Whauu/EspressiScale/README.md

# EspressiScale

EspressiScale is a minimalist and affordable espresso scale designed to provide accurate measurements along with a built-in timer – perfect for both home and small coffee shop use.

## Features

- **Accurate Weighing:** Provides precise measurements for your espresso brewing.
- **Built-in Timer:** Monitors brewing time to ensure optimal extraction.
- **Minimalist Design:** A simple and modern solution focusing on essential features.
- **BLE:** It now supports both Gaggimate and Clevercoffee (Beanconqueror support coming oct).
- **Calibration:** Now built in.

## Makerworld
This was also published on [makerworld](https://makerworld.com/en/models/1212476-espressiscale-small-minimalist-espresso-scale#profileId-1227630) for easy 3D printing.

## Bill of Materials V1 (BOM)

| Quantity | Component | Details/Notes |
|---|---|---|
| 1 | [Lilygo T-Touch bar](https://lilygo.cc/products/t-touch-bar?variant=42880705102005) | |
| 1 | Battery | Any 3.7v rechargeable lithium battery (<10x34x48) |
| 1 | [500g Load Cell](https://www.aliexpress.com/item/1005006390450639.html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) | |
| 1 | [HX711](https://www.aliexpress.com/item/1005006293368575.html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) | High precision (available on AliExpress) |
|1 | [USB type C port](https://a.aliexpress.com/_EyspPbK) | Not yet implimented
| 4 | [M3x3.0 Threaded Inserts](https://cnckitchen.store/products/heat-set-insert-m3-x-3-short-version-100-pieces) | (I used CNCkitchen) |
| 2 | M3x10 Screws | M3x6 for V2 |
| 2 | M3x12 Screws | M3x8 for V2 |
| 2 | M3x12 Countersunk Screws | |
| - | Heat Shrink | |

### Optional Components

| Quantity | Component | Details/Notes |
|---|---|---|
| 2 | Extra Heated Inserts | |
| 2 | M3x6 Screws | M3x4 for V2 |

## Installation

1. Open [this](https://doc.espressiscale.com) website in chrome
2. Connect your scale and hold down boot while pressing res once, then releasing boot
3. Press Install button, selecting your scale (jtag), hit "install EspressiScale"
4. Once done, look for wifi AP "EspressiScale" and connect to it (Password: Espressi)
5. Put in the credentials for your home wifi.
6. Connect to the same wifi with any device and go to espressiscale.local
7. Press calibration and follow the on screen steps.
8. You're done!
(If you see nan, please calibrate and restart the scale)

## Update:
til

## Usage
**Touch controls:**
- **Left Display:** Starts and stops timer
- **Right Display:** Tares weight and resets timer
- **Hold Any Side:** Goes to sleep
  
**Power:**
  - Touch the display anywhere to wake it up
  - The scale will automatically enter deep sleep after 5min with no use

## Re-Calibrating purchased scale
- Go to espressiscale.local, press calibration and follow the steps

## License
This project is licensed under my own license

## [Discord](https://discord.gg/syZnh8SXb7)

## Contact
If you have any questions or suggestions, you can:
- Open an issue in the GitHub repository
- Contact me directly at [hasse@espressiscale.com]
