Whauu/EspressiScale/(threads)

Thread 1 (2025-03-17):

Battery Voltage

chrisheib, 2025-03-17:
What voltage should the battery provide? Tried to find info on the t-touch but it's not specified on the product page.

Whauu, 2025-03-17:
Not sure of the exact specs, but most common batteries are 3.7v so id stick with that.

Closed 2025-03-19.

Thread 2 (2025-03-18):

Code Documentation

lnart, 2025-03-18:
I could not find any documentation on the source code that would enable me to use this project as a base for another project.

lnart, 2025-03-20:
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

Whauu, 2025-03-20:
My apologies, i go a little annoyed with the slightly entitled comment. Here is a better response:
What do you want me to document?
I’m a full time student and the project became bigger than i planned, so there's currently alot on my plate

stevelup, 2025-03-25:
The code is completely self explanatory in my opinion. If someone has the ability to use this project as a base for another project then they can understand the code anyway...

Closed 2025-04-07.

Thread 3 (2025-03-19):

Awesome project. Which USB-C board are you going to use?

darox, 2025-03-19:
Which USB-C board are you going to use?

Whauu, 2025-03-19:
[Link](https://a.aliexpress.com/_EQKREJa)
Ill post it in the readme file aswell

Whauu, 2025-03-28:
Ive misinterpreted the schematics so that usbc will only work for flashing not charging.
[Here](https://a.aliexpress.com/_EyspPbK) is the new board ill be using

Closed 2025-03-19.

Thread 4 (2025-03-30):

Concerns about deep sleep actually working

kevinstampe, 2025-03-30:
Hi
I built the scale yesterday, and am experiencing it taking a fully charged 400mAH battery from 4.1v to 3.0v in 24 hrs, with under 10 min total screen on time.
I even tried modifing the code to not include the wifi manager, but it seems like it still drains really fast.

Any idea on why this is?

Whauu, 2025-03-31:
Really shouldnt drain that fast as it enters deep sleep. The power draw is something like 0.3mA. Also the battery you’re using is a bit small. I’m using a 500mah just for testing and that lasts a decent amount. Lastly check if the hx711 is connected to the correct pin and not 3v3 pin.

Whauu, 2025-04-03:
Should stop at 4.2v

Whauu, 2025-04-03:
Btw soon ill post updated 3d files with added support for a bigger battery (1000mah 603048) and usbc charging

kevinstampe, 2025-04-12:
I've built a little voltage print into the code on my scale, just to see what happens now. Gotta love debugging :D
Also got the OTA updater working on my scale, great work!
And i've also got a 1200mAH battery now, a 103040 :)

KeiranSolaris, 2025-04-25:
I've noticed similar behavior where the scale only holds a charge for about 3 days with only maybe 15 minutes of use per day.

I used 650mAh battery. Last charging cycle I hooked up a power meter and measured just over 650mAh during charging before the light on the board turned green and it stopped so I don't believe the issue is the battery not charging fully.

I will say the scale seems to have issues with my wifi as well, I only really saw it connect to the network once, usually my router reports it as disconnected. Not sure if it the board just doesn't like my mesh network with a combined 2.4 and 5ghz network with the same SSID or maybe the wifi on my board is bad. Going to try and comment out the wifi commands and see after another full charge if that makes things better.

@kevinstamp did you do anything special to get OTA working or to get better battery life or was it just swapping to a larger battery?

Whauu, 2025-04-26:
It looks like your Wi-Fi might be the issue. If it’s constantly dropping in and out, it could be draining your battery. The built-in Wi-Fi isn’t the best, but since it’s mostly plastic, it shouldn’t be a major problem. I tested it with a 300mAh battery, and it lasted longer than what you’re reporting. It didn’t have “prettyota” back then, so I’ll see if that makes a difference.

KeiranSolaris, 2025-04-26:
I went through and commented out all the wifi and ota bits of code and then reuploaded it so we'll see if that does any better. Noticed this morning after doing that the scale sometimes when I would tare it would reboot which was new behavior. Probably need to go look over the edits I made and make sure I didn't accidentally do something weird. First though I need a coffee...

Whauu, 2025-05-04:
Ive tested the scale with a 1000mah battery now. With 5min use per day it lasts ~2 weeks. This is also while testing BLE functionality. You can probably make it last quite a lot longer if you reduce the sleep timer down from 5min to say 2min.

KeiranSolaris, 2025-05-05:
Good to know. Running a few more tests with wifi/ota commented out it still seems that the battery is drained in about 3 days regardless of use so seems like for some reason my board isn't actually going into deep sleep. Letting the scale sit idle and just waking it once a day after 3 days it won't wake and upon charging takes the full 650mAh. That means about 15 minutes of screen on time with the 5min timeout so I doubt that it's just the screen consuming too much and likely something screwy with my board and it not actually going to sleep.

kevinstampe, 2025-05-05:
@KeiranSolaris My experience is the same, though its maybe 4-5 days with a 1200mah battery.

KeiranSolaris, 2025-05-05:
That's interesting as that would be pretty similar battery drain as what I'm seeing with the 650 but sounds dramatically different than Whauu's results. I don't particularly have a ton of time to chase this down and dig through the code but if there was a version with some debug log or something I'd be happy to flash that and provide the results.

Whauu, 2025-05-17:
Sorry for the late reply (exam period). Ill look into making a debug version.
You can try probing the pins for the display to check if voltage still is supplied while in deep sleep. It shouldnt but i can only imagine that as the issue since the hx711 has a very low power draw anyways.

KeiranSolaris, 2025-05-17:
Yeah no worries on that, I remember exam days. I'll charge it up and probe some pins and see if anything obvious pops out. Based on the discussions I've read on the discord sounds like lilygo isn't making this screen anymore so if it is a quirk of the hardware might not be an issue for future designs/releases. Happy to ping you there if that is easier than communicating on a closed github issue as well. If you work out some debug code and would like me to run it and see if I can provide any feedback I'm happy to do so.

KeiranSolaris, 2025-05-17:
So as an update, I charged it up a bit when awake I detect 3.15V on pin 6 which is what the VCC on the HX711 is connected to. When the device goes to sleep and the screen is off I get 0V on pin 6 so it doesn't seem that it is the board providing power to the HX711 even when asleep.

Do we know what the power draw is when asleep and when the device is on? Maybe this is expected behavior with a 600mAh battery with 10mins daily use over 3 days?

KeiranSolaris, 2025-05-17:
Oh good call, I did miss commenting out the include ota.h so disabled that as well and reflashed it. I'll let it charge up and then check it one a day for power and we'll see how long it lasts. It being Sat if this behaves like it was before then I'd expect it to be dead Tues-Weds.

Closed 2025-04-19.

Thread 9 (2025-08-27):

Compilation error Espressiscale-Main

StrobesAV, 2025-08-27:
Just compiled the code. Had to correct pin definition in esp32s3box>pins_arduino.h to match  src>jd9613.cpp

But dont know how to handle this?

```
Compiling .pio\build\esp32s3box\libddb\lvgl\extra\widgets\tileview\lv_tileview.c.o
lib/lvgl/src/extra/widgets/tabview/lv_tabview.c: In function 'lv_tabview_add_tab':
lib/lvgl/src/extra/widgets/tabview/lv_tabview.c:89:25: warning: assignment discards 'const' qualifier from pointer target type [-Wdiscarded-qualifiers]
         new_map[tab_id] = "";
                         ^
lib/lvgl/src/extra/widgets/tabview/lv_tabview.c:98:24: warning: assignment discards 'const' qualifier from pointer target type [-Wdiscarded-qualifiers]
             new_map[1] = "";
                        ^
lib/lvgl/src/extra/widgets/tabview/lv_tabview.c:101:37: warning: assignment discards 'const' qualifier from pointer target type [-Wdiscarded-qualifiers]
             new_map[tab_id * 2 - 3] = "\n";
                                     ^
lib/lvgl/src/extra/widgets/tabview/lv_tabview.c:103:37: warning: assignment discards 'const' qualifier from pointer target type [-Wdiscarded-qualifiers]
             new_map[tab_id * 2 - 1] = "";
                                     ^
lib/lvgl/src/extra/widgets/tabview/lv_tabview.c: In function 'lv_tabview_constructor':
lib/lvgl/src/extra/widgets/tabview/lv_tabview.c:214:21: warning: assignment discards 'const' qualifier from pointer target type [-Wdiscarded-qualifiers]
     tabview->map[0] = "";
                     ^
Compiling .pio\build\esp32s3box\libddb\lvgl\extra\widgets\win\lv_win.c.o
```

Thread 10 (2025-09-01):

calibration factor

StrobesAV, 2025-09-01:
As it was impossible for me get T-Touch Bar, I'm testing using Esp32-S3 N16R8.
Without correct hardware I can not take advantage of using calibration over Web. But my attempts to use old method outlined in the documentation are failing.
This is my calibration factor: `scale.set_offset(-4987435); and scale.set_scale(3103.890381)`
The manual says:  _Open scale.cpp and insert the calibration factor you found._
So I made this change to the scale.cpp : ` float calibration_factor = 3103.890381; // Default value`
But it does not work. This is what I'm getting from JTAG. Numbers change if pressure applied to the cell, but obviously incorrect.
How I should apply the calibration factor? (by the way I see request for calibration factor when board boots first time over serial when connected to JTAG. But it accepts first keystroke without waiting for final number)

-499189.34Notified weight: -499189.34
-499190.97Notified weight: -499190.97

StrobesAV, 2025-09-02:
I was using incorrect calibration factor

Closed 2025-09-02.
