Whauu/EspressiScale/(commit log)

2025-04-12 Update Scale_calibration.ino
    Added missing line for powering the hx711 and added a tare (t) button.
2025-04-19 Update README.md
    Added calibration instructions for customers who purchased complete scale
2025-05-23 Fix
    Fixed a problem that could result in poor battery life
    [main.cpp]
2025-05-23 Fix to the fix
    Accidentally removed a very important line of code in the last fix
    [main.cpp]
2025-05-27 Updated calibration
    Added an easier way to enter calibration factor. Simply write it in console on first install
2025-06-05 Update
    Updated PrettyOTA and removed old calibration code.
2025-07-19 1.3.0
    Added BLE;
    Gaggimate is now supported on their nightly firmware
    [min_spiffs.csv]
2025-07-19 Fixed OTA
    Broke OTA with last update, should be fixed now
    [main.cpp]
2025-08-22 Fixed macos issues
    Fixed case sensitive header issue building in macos
    [WiFi.hpp, main.cpp]
2025-09-02 1.4.0
    Added:
    -Hold to sleep
    -Firmware integrated calibration
    -Other QOL improvements
2025-09-02 Revise README with new installation and calibration details
    Updated installation instructions and added calibration steps.
2025-09-03 Update README with calibration instructions
    Added note for calibration issue with scale.
2025-09-03 Revise component details in README.md
    Updated screw specifications for V2 and added details for M3x6 and M3x12 screws.
2025-09-03 1.4.1
    Fixed a battery related issue
    [main.cpp]
